icecoke0913-code/STM32F4-ventilator/参数/mq2背面.JPG

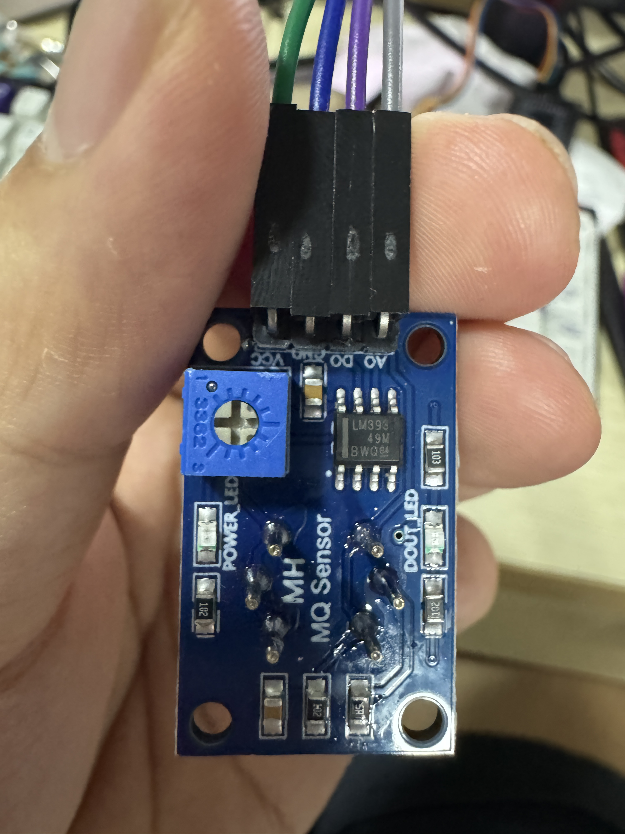
参数/mq2背面.JPG
