icecoke0913-code/STM32F4-ventilator/docs/hardware-connections.md

# 硬件连接记录

## 供电原则

- 电机电源与编码器逻辑电源分开。
- STM32、TB6612、编码器、传感器和显示屏必须共地。
- 编码器已使用3.3V供电并完成空载计数；C1/C2输出类型仍未用万用表确认，当前使用STM32内部上拉。
- MQ-2加热端使用5V，模拟输出进入STM32前不得超过3.3V。
- TB6612模块实物已带约10μF储能电容和小型去耦电容；M4使用模块现有电容。

## 计划引脚

| 模块信号 | STM32引脚 | 状态 |
|---|---|---|
| PA0用户按键 | PA0 | 板载S1，按下接3.3V，配置内部下拉 |
| 编码器A / C1 | PC6 / TIM3_CH1 | 已接线，内部上拉，固定正转时计数递减 |
| 编码器B / C2 | PC7 / TIM3_CH2 | 已接线，内部上拉，三挡空载测速正常 |
| TB6612 PWMA | PB6 / TIM4_CH1 | 已接线，20kHz PWM和30%/50%/70%空载调速通过 |
| TB6612 AIN1 | PB7 | 已接线，固定正转方向通过 |
| TB6612 AIN2 | PB8 | 已接线，固定正转方向通过 |
| TB6612 STBY | PB9 | 已接线，上电停止、0%停止和RST安全通过 |
| MQ-2 AO | PC0 / ADC1_IN10 | 必须经约0.6倍分压，禁止直接连接 |
| DHT11 DATA | PD0 | 已接线，正常采集、断线TIMEOUT和无复位自动恢复通过 |
| ST7735S SCL | PB13 / SPI2_SCK | 屏幕丝印SCL，SPI时钟 |
| ST7735S SDA | PB15 / SPI2_MOSI | 屏幕丝印SDA，SPI数据输入 |
| ST7735S CS | PD7 | 屏幕丝印CS |
| ST7735S DC | PD6 | 屏幕丝印DC |
| ST7735S RST | PD5 | 屏幕丝印RST |
| ST7735S BLK | PD4 | 屏幕丝印BLK，背光控制 |
| ST7735S VDD | 3.3V | 第一阶段使用3.3V供电 |
| ST7735S GND | GND | 与STM32共地 |
| 板载W25QXX SCK | PB3 / SPI1_SCK | 第一阶段预留，需关闭JTAG保留SWD |
| 板载W25QXX MISO | PB4 / SPI1_MISO | 第一阶段预留，需关闭JTAG保留SWD |
| 板载W25QXX MOSI | PB5 / SPI1_MOSI | 第一阶段预留 |
| 板载W25QXX CS | PA15 | 原理图网络名F_CS，第一阶段预留 |
| USART1 TX | PA9 | 已规划，未接线验证 |
| USART1 RX | PA10 | 已规划，未接线验证 |

## 电机与编码器实际六线映射

已根据购买的编码器转杜邦线转接板实物丝印确认。转接板丝印从左到右为：

```text
M2、VCC、C2、C1、GND、M1
```

| 线色 | 丝印 | 功能 | M4连接 |
|---|---|---|---|
| 绿 | M2 | 电机端2 | TB6612 AO2 |
| 橙 | VCC | 编码器3.3V电源 | 不连接，单独绝缘 |
| 黄 | C2 | 编码器相位2 | 不连接，单独绝缘 |
| 白 | C1 | 编码器相位1 | 不连接，单独绝缘 |
| 红 | GND | 编码器地 | 不连接，单独绝缘 |
| 黑 | M1 | 电机端1 | TB6612 AO1 |

M4只连接黑色M1和绿色M2。M5已将橙色VCC接3.3V、红色GND接系统地、白色C1接PC6、黄色C2接PC7。旧产品图片推断的线色映射不再使用。

## 电机转接线使用要求

电机原始六根线已通过专用转接线转换为杜邦接口，不再采用裸线临时连接。连接和移动转接线前必须先断开9V适配器、STM32 USB-C、ST-Link和USB转TTL。M5接入编码器前，需要单独确认C1/C2的电气输出类型以及是否需要外接上拉电阻，不能继续沿用旧产品图片的推断。

## M4 TB6612供电与接线

```text
9V适配器 → DC-DC输入
DC-DC 5V → TB6612 VM
STM32 3.3V → TB6612 VCC
STM32 GND、DC-DC GND、TB6612 GND → 共地
黑色M1 → TB6612 AO1
绿色M2 → TB6612 AO2
```

- 禁止把DC-DC的VIN或9V直通输出接到TB6612 VM或电机。
- STM32继续通过USB-C供电，不使用DC-DC给STM32反向供电。
- M4只使用TB6612 A通道，B通道不连接。
- M4固定使用`AIN1=高、AIN2=低`正转；方向不符合需求时，只能完全断电后交换AO1与AO2上的电机线。
- 初始安全状态为STBY低、PWM为0、AIN1低、AIN2低；上电或复位后电机不得自动旋转。

TB6612模块实物引脚按已确认照片方向从上到下为：

```text
左侧：PWMA、AIN2、AIN1、STBY、BIN1、BIN2、PWMB、GND
右侧：VM、VCC、GND、AO1、AO2、BO2、BO1、GND
```

## MQ-2分压要求

- 模块VCC接5V，GND接系统地。
- 商家《产品使用手册》明确写明：该LM393模块的模拟量输出为`0~5V`，浓度越高电压越高；因此AO不是3.3V安全输出。
- 只使用AO，第一阶段不使用DO。
- AO先经过约0.6倍分压再进入PC0，例如AO经10kΩ串联到PC0、PC0再经15kΩ接地。
- 分压后的理论最大值为5V × 15/(10+15) = 3.0V。
- 正式接PC0前，先用万用表测量模块AO和分压节点电压。
- 手册同时称DO为低电平有效TTL输出且“可直接接单片机”，但未给出高电平最大电压；PC0是ADC输入，不可把DO接到PC0。若以后使用DO，必须选择确认具备5V容忍能力的数字GPIO，并先核对开发板实际引脚。
- 当前没有万用表和分压器件，MQ-2的AO、DO均保持断开。

## DHT11接线要求

M3A使用三针DHT11模块，规划接线为：

| DHT11信号 | 连接位置 | 说明 |
|---|---|---|
| VCC | STM32 3.3V | 不使用5V，确保板载数据上拉电平安全 |
| DATA | PD0 | 单总线数据，驱动中动态切换开漏输出与输入 |
| GND | STM32 GND | 与开发板共地 |

- 三针模块通常带板载数据上拉，因此M3A不增加外部上拉电阻。
- 接线前必须按实物丝印确认VCC、DATA和GND顺序，不能按针脚位置猜测。
- M3A测试时MQ-2的AO和DO均不得连接STM32。
- DHT11运行中DATA线断开会稳定报告TIMEOUT，重新接回后无需复位即可恢复OK；两次重复测试均已通过。

## 已确认电机参数

- 型号：JGA12-N20-50B。
- 额定电压：6V；允许范围：3～12V。
- 空载转速：300 RPM；空载电流：40mA。
- 最大效率点：225 RPM、155mA、0.14kg·cm。
- 堵转电流：0.55A；堵转转矩：0.7kg·cm。
- 减速比：50。
- 编码器四倍频理论计数：1400计数/输出轴圈。

## 待确认项

- ST7735S实际显示方向、颜色顺序和坐标偏移。
- ST7735S最终校准：竖屏128×160，MADCTL=0xC0，X Offset=0，Y Offset=0，BLK高电平点亮，SPI2时钟5.25MHz。
- 首次白屏由显示通信线物理连接不良导致；断电重新插接后恢复。移动杜邦线前必须先断开USB-C、ST-Link和USB转TTL。
- MQ-2模块AO及分压节点的实测最大电压。
- DC-DC模块实际输入电压，以及5V/3.3V各路实测电压。
- TB6612开环挡位与空载运行已通过；未使用万用表测量5V或启动压降，未进行堵转、带负载或长时间运行测试。

## 开发板原理图核对记录

- 资料：根目录 `stm32f407vet6.pdf`。
- MCU外部高速晶振：8 MHz。
- MCU外部低速晶振：32.768 kHz。
- 板载用户按键S1连接PA0，按下通过1 kΩ接到3.3V。
- 板载用户LED连接PA1，实际亮灭电平在M1阶段验证。
- P2 TFT接口：1=3.3V、2=GND、3=PB15、4=PB13、5=PB12、6=PB14、7=PC5、8=PB1；因购买的屏幕接口不匹配，本项目不使用该插座。
- 板载W25QXX：PA15=CS、PB3=SCK、PB4=MISO、PB5=MOSI。

## 参数资料来源

- `参数/st7735s背面.JPG`、`参数/st7735正面.JPG`
- `参数/mq2背面.JPG`、`参数/mq2正面.JPG`
- `参数/MQ-2.pdf`
- `参数/产品使用手册.doc`
- `参数/电机参数.png`
- `参数/电源模块.png`
- `参数/TB6612FNG_datasheet.pdf`
