icecoke0913-code/STM32F4-ventilator/docs/superpowers/plans/2026-08-18-m8a-dht11-auto.md

# M8A DHT11自动模式实施计划

> **For agentic workers:** REQUIRED SUB-SKILL: Use superpowers:executing-plans (recommended) or superpowers:subagent-driven-development to implement this plan task-by-task. Steps use checkbox (`- [ ]`) syntax for tracking.

**Goal:** 在不接入MQ-2的前提下，让DHT11温湿度驱动AUTO的STOP/LOW/HIGH目标，并验证传感器失效时安全停止。

**Architecture:** 新增纯函数`AutoPolicy`计算AUTO候选请求；App层以CMSIS-RTOS互斥量保护最新有效DHT11快照；MotorTask每50ms读取快照并通过扩展后的ModeManager生成最终请求。MANUAL、BACKFLOW、编码器故障和MotorTask唯一PWM所有权保持不变。

**Tech Stack:** STM32F407VET6、STM32CubeMX 6.16.1、STM32CubeF4 1.28.3、HAL、FreeRTOS/CMSIS-RTOS v2、Keil MDK-ARM V5、C。

**设计依据：** `docs/superpowers/specs/2026-08-18-m8a-dht11-auto-design.md`

---

### Task 1: 建立M8A基线和文档检查点

**Files:**
- Modify: `docs/superpowers/plans/2026-08-18-m8a-dht11-auto.md`
- Read: `firmware/SmartHood/App/Src/app_tasks.c`
- Read: `firmware/SmartHood/Control/Inc/mode_manager.h`

- [x] **Step 1: 确认工作区和正式开关**

```powershell
git status --short --branch
git log -3 --oneline --decorate
rg -n "APP_M7_SELF_TEST_ENABLED|APP_CONTROL_PI_SELF_TEST_ENABLED" `
  firmware/SmartHood/App/Src/app_tasks.c
```

Expected: 当前为`main...origin/main`，工作区干净，M7和PI临时自检开关均为`0U`。

- [x] **Step 2: 完整Rebuild基线**

```powershell
$uv4 = 'D:\Keil5\UV4\UV4.exe'
$project = 'D:\Keil5 prj\stm32f4\firmware\SmartHood\MDK-ARM\SmartHood.uvprojx'
$log = Join-Path $env:TEMP 'smarthood-m8a-baseline.log'
$args = @('-r', ('"' + $project + '"'), '-t', '"SmartHood"', '-o', ('"' + $log + '"'))
$p = Start-Process -FilePath $uv4 -ArgumentList $args -WindowStyle Hidden -Wait -PassThru
Get-Content $log
Write-Output ('UV4_EXIT=' + $p.ExitCode)
```

Expected: `0 Error(s), 0 Warning(s)`，正式尺寸仍为`Code=28778 RO-data=1422 RW-data=168 ZI-data=39672`。

- [x] **Step 3: 提交M8A基线记录**

```powershell
git add docs/superpowers/plans/2026-08-18-m8a-dht11-auto.md
git commit -m "docs: start M8A DHT11 auto implementation"
git push origin main
```

### Task 2: 为AutoPolicy写失败自检

**Files:**
- Create: `firmware/SmartHood/Control/Inc/auto_policy.h`
- Create: `firmware/SmartHood/Control/Test/auto_policy_selftest.h`
- Create: `firmware/SmartHood/Control/Test/auto_policy_selftest.c`
- Modify: `firmware/SmartHood/MDK-ARM/SmartHood.uvprojx`

- [x] **Step 1: 定义数据结构和纯函数接口**

在`auto_policy.h`中定义`AutoPolicySnapshot_t`，包含`int16_t temperature_x10`、`uint16_t humidity_x10`、`bool valid`和`uint32_t updated_tick`，并声明：

```c
ModeMotorRequest_t AutoPolicy_Evaluate(
    const AutoPolicySnapshot_t *snapshot,
    uint32_t now_tick,
    ModeMotorRequest_t previous_auto_request);
```

头文件必须包含`stdbool.h`、`stdint.h`和`mode_manager.h`，所有新增公开接口加中文注释。

- [x] **Step 2: 先写自检断言**

`auto_policy_selftest.c`分别构造独立快照和上一次请求，覆盖以下结果：

```c
valid=false                         -> MODE_MOTOR_STOP
updated_tick距now超过6000ms         -> MODE_MOTOR_STOP
26.0C/60%且previous=STOP            -> STOP
28.0C/60%且previous=STOP            -> LOW
32.0C/60%且previous=LOW             -> HIGH
31.0C/80%且previous=HIGH             -> LOW
27.0C/65%且previous=LOW              -> STOP
31.5C/82%且previous=HIGH             -> HIGH
非法previous请求                    -> 按STOP基线重新计算
```

每个断言失败立即返回`false`，中间结果不得使用`(void)`丢弃。

`auto_policy_selftest.h`声明`bool AutoPolicy_RunSelfTests(void);`，并包含必要的`stdbool.h`。

- [x] **Step 3: 将自检加入Keil工程并执行红灯Rebuild**

把`auto_policy_selftest.c`加入Keil的`Control Test` Group，确认已有`..Control\Inc;..\Control\Test`包含路径；执行完整Rebuild。

Expected: 链接阶段报告`AutoPolicy_Evaluate`未定义，得到大于0个Error，证明自检确实调用了尚未实现的接口。

### Task 3: 实现AutoPolicy最小逻辑

**Files:**
- Create: `firmware/SmartHood/Control/Src/auto_policy.c`
- Modify: `firmware/SmartHood/MDK-ARM/SmartHood.uvprojx`
- Test: `firmware/SmartHood/Control/Test/auto_policy_selftest.c`

- [x] **Step 1: 加入AutoPolicy实现**

在`auto_policy.c`中使用无符号Tick差判断过期：

```c
if ((snapshot == NULL) || !snapshot->valid ||
    ((uint32_t)(now_tick - snapshot->updated_tick) > 6000U))
{
    return MODE_MOTOR_STOP;
}
```

实现顺序必须是：先判断HIGH进入阈值，再依据`previous_auto_request`执行HIGH降档或LOW停止迟滞，最后判断LOW进入阈值。所有温湿度比较使用扩大10倍的整数：`320`、`850`、`310`、`800`、`280`、`700`、`270`、`650`。

- [x] **Step 2: 加入Keil工程并执行绿灯Rebuild**

将`auto_policy.c`加入`Control` Group，重新Rebuild。

Expected: `0 Error(s), 0 Warning(s)`；自检对象和实现对象均参与编译。

- [x] **Step 3: 提交纯算法模块**

```powershell
git add firmware/SmartHood/Control/Inc/auto_policy.h `
  firmware/SmartHood/Control/Src/auto_policy.c `
  firmware/SmartHood/Control/Test/auto_policy_selftest.c `
  firmware/SmartHood/Control/Test/auto_policy_selftest.h `
  firmware/SmartHood/MDK-ARM/SmartHood.uvprojx
git diff --cached --check
git commit -m "feat: add DHT11 auto policy"
git push origin main
```

### Task 4: 增加线程安全的DHT11快照

**Files:**
- Modify: `firmware/SmartHood/App/Src/app_tasks.c`
- Modify: `firmware/SmartHood/Core/Src/freertos.c`

- [x] **Step 1: 在App层增加共享对象**

在`app_tasks.c`中增加：

```c
static osMutexId_t app_sensor_mutex = NULL;
static AutoPolicySnapshot_t app_sensor_snapshot = {0};
```

增加三个带中文注释的静态函数：

```c
static bool App_SensorState_Init(void);
static void App_SensorState_Publish(const DHT11_Data_t *data,
                                    uint32_t now_tick);
static bool App_SensorState_Read(AutoPolicySnapshot_t *snapshot);
```

`App_SensorState_Init()`创建互斥量并将快照置为`valid=false`；Publish和Read在复制结构时使用`osMutexAcquire(..., 0U)`，失败时返回安全失败结果，不在锁内执行DHT11读取。

- [x] **Step 2: 在任务创建前初始化互斥量**

在`MX_FREERTOS_Init()`的`App_MotorControl_Init()`之后调用`App_SensorState_Init()`；失败调用`Error_Handler()`，保证三个任务启动前共享对象已经存在。

- [x] **Step 3: 发布有效DHT11数据**

在`App_SensorTask()`中，只有`BSP_DHT11_Read()`返回`DHT11_STATUS_OK`时调用`App_SensorState_Publish(&data, osKernelGetTickCount())`；TIMEOUT和CHECKSUM_ERROR只保留原有日志，不发布无效数据。

- [x] **Step 4: 执行Rebuild并提交**

Expected: `0 Error(s), 0 Warning(s)`，SensorTask原有日志行为保持不变。

```powershell
git add firmware/SmartHood/App/Src/app_tasks.c `
  firmware/SmartHood/App/Inc/app_tasks.h firmware/SmartHood/Core/Src/freertos.c
git diff --cached --check
git commit -m "feat: share validated DHT11 snapshot"
git push origin main
```

### Task 5: 扩展ModeManager并保持M7回归

**Files:**
- Modify: `firmware/SmartHood/Control/Inc/mode_manager.h`
- Modify: `firmware/SmartHood/Control/Src/mode_manager.c`
- Modify: `firmware/SmartHood/Control/Test/mode_manager_selftest.c`

- [x] **Step 1: 修改请求映射接口**

把接口改为：

```c
ModeMotorRequest_t ModeManager_GetMotorRequest(
    const ModeManager_t *manager,
    ModeMotorRequest_t auto_request);
```

AUTO且RUNNING且无故障时返回`auto_request`，但只接受STOP/LOW/HIGH；非法AUTO请求返回STOP。MANUAL忽略`auto_request`并继续使用预选挡位；BACKFLOW返回STOP；故障返回FAULT；STANDBY返回STOP。

- [x] **Step 2: 先更新所有自检调用**

M7已有自检调用统一传入`MODE_MOTOR_STOP`，并新增AUTO运行状态下传入LOW/HIGH/FAULT/非法值的断言。确认MANUAL和BACKFLOW结果不随第二参数改变。

- [x] **Step 3: 执行Rebuild并复核M7自检**

Expected: `0 Error(s), 0 Warning(s)`；临时打开M7自检时仍输出`M7 self-test PASSED`，否则保持正式开关为`0U`并继续下一步。

- [x] **Step 4: 提交ModeManager接口扩展**

```powershell
git add firmware/SmartHood/Control/Inc/mode_manager.h `
  firmware/SmartHood/Control/Src/mode_manager.c `
  firmware/SmartHood/Control/Test/mode_manager_selftest.c
git diff --cached --check
git commit -m "feat: allow mode manager auto requests"
git push origin main
```

### Task 6: 将AUTO策略接入MotorTask

**Files:**
- Modify: `firmware/SmartHood/App/Src/app_tasks.c`
- Modify: `firmware/SmartHood/Control/Test/auto_policy_selftest.c`

- [x] **Step 1: 增加AUTO候选请求状态**

在`App_MotorTask()`局部变量中增加`AutoPolicySnapshot_t sensor_snapshot`、`ModeMotorRequest_t auto_request`和`ModeMotorRequest_t previous_auto_request = MODE_MOTOR_STOP`。每个50ms周期先把`sensor_snapshot.valid`置为`false`，再调用`App_SensorState_Read()`；读取失败时保留这个无效快照并传给策略函数。

- [x] **Step 2: 计算最终请求**

将原来的：

```c
request = ModeManager_GetMotorRequest(&mode_manager);
```

改为：

```c
auto_request = AutoPolicy_Evaluate(
    &sensor_snapshot, now_tick, previous_auto_request);
request = ModeManager_GetMotorRequest(&mode_manager, auto_request);
previous_auto_request = auto_request;
```

最终请求变化后继续复用已有`App_MotorRequestToAction()`、PI复位和软启动逻辑；AUTO进入STOP时沿用`stop_motor`立即停机。

- [x] **Step 3: 增加可观察日志**

在现有约500ms控制日志中追加`auto_request`、`temp`、`humidity`和`sensor_age`字段；传感器无效时输出固定`temp=NA humidity=NA sensor_age=STALE`，不使用浮点格式化。

- [x] **Step 4: 执行Rebuild并提交集成**

Expected: `0 Error(s), 0 Warning(s)`；关闭临时自检时正式尺寸允许增加，但不能出现未定义符号或警告。

```powershell
git add firmware/SmartHood/App/Src/app_tasks.c
git diff --cached --check
git commit -m "feat: integrate DHT11 auto requests"
git push origin main
```

### Task 7: 加入M8A组合自检和临时板端验证

**Files:**
- Modify: `firmware/SmartHood/App/Src/app_tasks.c`
- Modify: `docs/test-records.md`

- [x] **Step 1: 增加组合自检函数**

在`APP_M8A_SELF_TEST_ENABLED`条件编译下增加`App_M8A_RunSelfTests()`，组合调用AutoPolicy和ModeManager自检，并验证：AUTO+RUNNING+LOW请求可达、AUTO+RUNNING+STOP停止、MANUAL不被AUTO候选请求覆盖、故障优先级不变。

- [x] **Step 2: 临时打开自检并Rebuild**

```c
#define APP_M8A_SELF_TEST_ENABLED 1U
```

Expected: `0 Error(s), 0 Warning(s)`，尺寸变化可记录，但不能出现警告。

- [x] **Step 3: VM断开条件下烧录**

完全断电，断开TB6612 `VM/9V`，保持ST-Link、USB转TTL、TFT和DHT11连接；烧录后打开115200串口并按RST。

Expected: `M8A auto policy self-test PASSED`、DHT11有效日志和`motor control ready, state=STOP`；电机不得转动。

- [x] **Step 4: 记录板端自检结果**

把实际串口现象写入`docs/test-records.md`，明确VM断开、DHT11接线和没有安装扇叶/机械负载。

### Task 8: VM断开系统行为验收

**Files:**
- Modify: `docs/test-records.md`

- [ ] **Step 1: 验证无效和恢复**

未执行运行中DHT11断线：项目禁止带电插拔传感器线路；无效快照和6000ms过期STOP由板端固定输入自检覆盖。

在VM断开时保持系统运行，确认DHT11为`status=OK`；断开DHT11 DATA线，观察最多约6秒后AUTO候选变为STOP；重新接回并等待有效读取，确认候选请求恢复。

- [x] **Step 2: 验证AUTO模式切换**

长按取得RUNNING，保持AUTO，观察温湿度和AUTO请求日志；短按进入MANUAL，确认双击LOW/HIGH仍按M7规则工作；再次短按进入BACKFLOW，确认请求仍为STOP。

- [ ] **Step 3: 验证安全停止**

STANDBY和RST停止已通过；本阶段未重复执行编码器运行中断线，因此该步骤保留未勾选。

验证长按进入STANDBY、RST复位、编码器故障锁存和故障长按清除；所有路径都必须保持PWM为0，无VM时不得因策略日志导致任务阻塞。

- [x] **Step 4: 关闭临时自检**

恢复：

```c
#define APP_M8A_SELF_TEST_ENABLED 0U
```

### Task 9: 正式构建、文档和Git收尾

**Files:**
- Modify: `firmware/SmartHood/App/Src/app_tasks.c`
- Modify: `docs/project-guide.md`
- Modify: `docs/test-records.md`
- Modify: `docs/superpowers/plans/2026-08-18-m8a-dht11-auto.md`

- [x] **Step 1: 正式Rebuild**

Expected: Keil `0 Error(s), 0 Warning(s)`，记录Code/RO/RW/ZI和HEX SHA-256；正式开关必须为`0U`。

- [x] **Step 2: 更新项目文档**

只把实际完成的DHT11 AUTO、数据过期停止、MANUAL/BACKFLOW回归和VM断开验收标为通过；MQ-2融合、真实BACKFLOW、扇叶、机械负载、堵转和长时间温升继续标记为未执行或未开始。

- [x] **Step 3: 提交正式版本**

```powershell
git add firmware/SmartHood/App/Src/app_tasks.c `
  docs/project-guide.md docs/test-records.md `
  docs/superpowers/plans/2026-08-18-m8a-dht11-auto.md
git diff --cached --check
git commit -m "feat: add DHT11 automatic mode"
git push origin main
git status --short --branch
```

Expected: `main...origin/main`且工作区无未提交文件。

---

## 执行前安全约束

- MQ-2 AO/DO在整个M8A计划中保持断开；没有分压器件和万用表时不改变此约束。
- 所有临时自检烧录和DHT11断线测试都必须断开TB6612 VM/9V。
- 禁止安装扇叶、机械负载或执行堵转测试。
- 禁止带电插拔电机、TB6612、编码器或传感器线路。
- 正式M8A固件烧录前确认`APP_M8A_SELF_TEST_ENABLED=0U`。
