icecoke0913-code/STM32F4-ventilator/docs/superpowers/plans/2026-07-23-m2-st7735s-display.md

# M2 ST7735S Display Implementation Plan

> **For agentic workers:** REQUIRED SUB-SKILL: Use superpowers:subagent-driven-development (recommended) or superpowers:executing-plans to implement this plan task-by-task. Steps use checkbox (`- [ ]`) syntax for tracking.

**Goal:** Configure SPI2 and build a project-specific blocking HAL driver that initializes and validates the external 1.8-inch 128×160 ST7735S display while preserving the M1 FreeRTOS heartbeat, key and serial functions.

**Architecture:** CubeMX owns SPI2 and GPIO initialization. Handwritten display transport, graphics primitives and a minimal hardware-test font live in the BSP layer; `App_DefaultTask` calls only public BSP functions. The first version uses blocking SPI without a framebuffer, DMA or a new RTOS task, while preserving an RGB565 rectangle-write boundary for the M9 LVGL port.

**Tech Stack:** STM32F407VET6, STM32CubeMX 6.16.1, STM32CubeF4 1.28.3, Keil MDK 5.24a/ARMCC 5.06, STM32 HAL, FreeRTOS CMSIS-RTOS v2, SPI2, ST7735S

---

## M2 Safety and Acceptance

During M2, connect only the STM32 board, ST-Link, USB-to-UART and TFT. Do not connect MQ-2, DHT11, TB6612, motor or encoder.

Power arrangement:

```text
STM32 board: USB-C
TFT: board 3.3V and board GND
ST-Link: SWDIO, SWCLK and GND only
ST-Link 3.3V/5V: disconnected
USB-to-UART power pins: disconnected
```

M2 functionally passes when:

- Keil reports `0 Error(s), 0 Warning(s)`.
- M1 USART1 heartbeat, PA0 and PA1 behavior remain operational.
- PD4 controls the TFT backlight.
- Red, green and blue test screens match their requested colors.
- Portrait coordinates cover `(0,0)` through `(127,159)` without a missing edge.
- The final test screen shows `SmartHood`, `ST7735S OK` and `128x160`.
- No unexpected reset occurs during repeated display operations.

## Planned Files

```text
Modify: firmware/SmartHood/SmartHood.ioc
Generate: firmware/SmartHood/Core/Inc/spi.h
Generate: firmware/SmartHood/Core/Src/spi.c
Generate/modify: firmware/SmartHood/Core/Inc/main.h
Generate/modify: firmware/SmartHood/Core/Src/gpio.c
Create: firmware/SmartHood/BSP/Inc/fonts.h
Create: firmware/SmartHood/BSP/Src/fonts.c
Create: firmware/SmartHood/BSP/Inc/bsp_st7735s.h
Create: firmware/SmartHood/BSP/Src/bsp_st7735s.c
Modify: firmware/SmartHood/App/Src/app_tasks.c
Modify through Keil GUI: firmware/SmartHood/MDK-ARM/SmartHood.uvprojx
Update: docs/hardware-connections.md
Update: docs/test-records.md
Update: docs/project-guide.md
```

### Task 1: Protect the M1 Baseline

**Files:**

- Verify: `firmware/SmartHood/SmartHood.ioc`
- Verify: `firmware/SmartHood/Core/Src/freertos.c`
- Verify: `firmware/SmartHood/App/Src/app_tasks.c`

- [x] **Step 1: Commit the approved M2 documents on main and create a feature branch**

```powershell
git add docs/project-guide.md docs/superpowers/plans/2026-07-23-m2-st7735s-display.md
git commit -m "docs: add M2 ST7735S implementation plan"
git push
git switch -c feature/m2-st7735s
```

Expected: the new local branch is `feature/m2-st7735s` and M2 firmware changes do not start directly on `main`.

- [x] **Step 2: Confirm the Git working tree before CubeMX changes**

Run from the repository root:

```powershell
git status
git log --oneline -3
```

Expected: the current M1 work is committed, and no unexplained source change is pending.

- [x] **Step 3: Record the current build**

Press `F7` in Keil.

Expected:

```text
0 Error(s), 0 Warning(s)
Program Size: Code=18416 RO-data=1048 RW-data=148 ZI-data=39364
```

The exact size may differ slightly after Keil project metadata changes, but any difference must be explained.

- [x] **Step 4: Confirm CubeMX preservation points**

In `Core/Src/freertos.c`, confirm:

```c
/* USER CODE BEGIN Includes */
#include "app_tasks.h"
/* USER CODE END Includes */
```

and:

```c
void StartDefaultTask(void *argument)
{
  /* USER CODE BEGIN StartDefaultTask */
  App_DefaultTask(argument);
  /* USER CODE END StartDefaultTask */
}
```

Stop if either block is missing.

### Task 2: Configure SPI2 and TFT GPIO in CubeMX

**Files:**

- Modify: `firmware/SmartHood/SmartHood.ioc`
- Generate: `firmware/SmartHood/Core/Inc/spi.h`
- Generate: `firmware/SmartHood/Core/Src/spi.c`
- Generate/modify: `firmware/SmartHood/Core/Inc/main.h`
- Generate/modify: `firmware/SmartHood/Core/Src/gpio.c`

- [x] **Step 1: Enable SPI2 transmit-only master mode**

Open `SmartHood.ioc`, then choose `Connectivity -> SPI2`:

```text
Mode: Transmit Only Master
PB13: SPI2_SCK
PB15: SPI2_MOSI
```

PB14 is not used by the display.

- [x] **Step 2: Configure the SPI2 parameter settings**

Use:

```text
Frame Format: Motorola
Data Size: 8 Bits
First Bit: MSB First
Clock Polarity: Low
Clock Phase: 1 Edge
Baud Rate Prescaler: 8
NSS Signal Type: Software
CRC Calculation: Disabled
```

With APB1 at 42MHz, the initial SPI2 clock is `42MHz / 8 = 5.25MHz`.

Do not enable SPI2 DMA or interrupts.

- [x] **Step 3: Configure TFT_CS on PD7**

Select PD7 as `GPIO_Output`:

```text
User Label: TFT_CS
Initial Output Level: High
Mode: Output Push Pull
Pull: No Pull
Speed: Low
```

- [x] **Step 4: Configure TFT_DC on PD6**

Select PD6 as `GPIO_Output`:

```text
User Label: TFT_DC
Initial Output Level: Low
Mode: Output Push Pull
Pull: No Pull
Speed: Low
```

- [x] **Step 5: Configure TFT_RST on PD5**

Select PD5 as `GPIO_Output`:

```text
User Label: TFT_RST
Initial Output Level: High
Mode: Output Push Pull
Pull: No Pull
Speed: Low
```

- [x] **Step 6: Configure TFT_BLK on PD4**

Select PD4 as `GPIO_Output`:

```text
User Label: TFT_BLK
Initial Output Level: Low
Mode: Output Push Pull
Pull: No Pull
Speed: Low
```

- [x] **Step 7: Check the clock and pin map before generation**

Confirm that the existing clock tree remains:

```text
SYSCLK/HCLK: 168MHz
APB1: 42MHz
APB2: 84MHz
```

Confirm no red conflict marker appears on PB13, PB15 or PD4-PD7.

- [x] **Step 8: Generate the code**

Click `GENERATE CODE`.

After generation, confirm these macros exist in `Core/Inc/main.h`:

```c
#define TFT_BLK_Pin GPIO_PIN_4
#define TFT_BLK_GPIO_Port GPIOD
#define TFT_RST_Pin GPIO_PIN_5
#define TFT_RST_GPIO_Port GPIOD
#define TFT_DC_Pin GPIO_PIN_6
#define TFT_DC_GPIO_Port GPIOD
#define TFT_CS_Pin GPIO_PIN_7
#define TFT_CS_GPIO_Port GPIOD
```

- [x] **Step 9: Reopen Keil and repair the old DFP mapping only if CubeMX overwrote it**

The old compatible pack uses:

```text
Device: STM32F407VE
Pack: Keil.STM32F4xx_DFP.1.0.8
```

Do not change the MCU source define or startup file manually. Remap the Keil target device through `Options for Target -> Device` only if the project reports the old device-pack error again.

- [x] **Step 10: Perform an empty-peripheral build**

Press `F7` before adding BSP code.

Expected:

```text
compiling spi.c...
0 Error(s), 0 Warning(s)
```

Verify that USART1 heartbeat still works after flashing this generated-only build.

- [x] **Step 11: Commit the CubeMX peripheral configuration**

```powershell
git add firmware/SmartHood/SmartHood.ioc firmware/SmartHood/Core firmware/SmartHood/MDK-ARM/SmartHood.uvprojx
git commit -m "feat: configure SPI2 and TFT control GPIO"
git push
```

### Task 3: Create the BSP Structure and Minimal Test Font

**Files:**

- Create: `firmware/SmartHood/BSP/Inc/fonts.h`
- Create: `firmware/SmartHood/BSP/Src/fonts.c`
- Modify through Keil GUI: `firmware/SmartHood/MDK-ARM/SmartHood.uvprojx`

- [x] **Step 1: Create BSP directories**

Create:

```text
firmware/SmartHood/BSP/Inc
firmware/SmartHood/BSP/Src
```

- [x] **Step 2: Create `fonts.h`**

```c
#ifndef FONTS_H
#define FONTS_H

#include <stdbool.h>
#include <stdint.h>

#define FONT_5X7_WIDTH   5U
#define FONT_5X7_HEIGHT  7U

bool Fonts_GetGlyph5x7(char character, uint8_t glyph[FONT_5X7_WIDTH]);

#endif
```

- [x] **Step 3: Create `fonts.c`**

The M2 font intentionally contains only characters required by the hardware-test screen. M9 uses LVGL fonts instead of extending this table.

```c
#include "fonts.h"

#include <stddef.h>

typedef struct
{
    char character;
    uint8_t columns[FONT_5X7_WIDTH];
} FontGlyph5x7;

static const FontGlyph5x7 glyphs[] =
{
    { ' ', { 0x00U, 0x00U, 0x00U, 0x00U, 0x00U } },
    { '?', { 0x02U, 0x01U, 0x51U, 0x09U, 0x06U } },
    { '0', { 0x3EU, 0x51U, 0x49U, 0x45U, 0x3EU } },
    { '1', { 0x00U, 0x42U, 0x7FU, 0x40U, 0x00U } },
    { '2', { 0x42U, 0x61U, 0x51U, 0x49U, 0x46U } },
    { '3', { 0x21U, 0x41U, 0x45U, 0x4BU, 0x31U } },
    { '5', { 0x27U, 0x45U, 0x45U, 0x45U, 0x39U } },
    { '6', { 0x3CU, 0x4AU, 0x49U, 0x49U, 0x30U } },
    { '7', { 0x01U, 0x71U, 0x09U, 0x05U, 0x03U } },
    { '8', { 0x36U, 0x49U, 0x49U, 0x49U, 0x36U } },
    { 'H', { 0x7FU, 0x08U, 0x08U, 0x08U, 0x7FU } },
    { 'K', { 0x7FU, 0x08U, 0x14U, 0x22U, 0x41U } },
    { 'O', { 0x3EU, 0x41U, 0x41U, 0x41U, 0x3EU } },
    { 'S', { 0x46U, 0x49U, 0x49U, 0x49U, 0x31U } },
    { 'T', { 0x01U, 0x01U, 0x7FU, 0x01U, 0x01U } },
    { 'a', { 0x20U, 0x54U, 0x54U, 0x54U, 0x78U } },
    { 'd', { 0x38U, 0x44U, 0x44U, 0x48U, 0x7FU } },
    { 'm', { 0x7CU, 0x04U, 0x18U, 0x04U, 0x78U } },
    { 'o', { 0x38U, 0x44U, 0x44U, 0x44U, 0x38U } },
    { 'r', { 0x7CU, 0x08U, 0x04U, 0x04U, 0x08U } },
    { 't', { 0x04U, 0x3FU, 0x44U, 0x40U, 0x20U } },
    { 'x', { 0x44U, 0x28U, 0x10U, 0x28U, 0x44U } }
};

bool Fonts_GetGlyph5x7(char character, uint8_t glyph[FONT_5X7_WIDTH])
{
    size_t index;
    size_t column;
    const uint8_t *source = NULL;

    if (glyph == NULL)
    {
        return false;
    }

    for (index = 0U; index < (sizeof(glyphs) / sizeof(glyphs[0])); index++)
    {
        if (glyphs[index].character == character)
        {
            source = glyphs[index].columns;
            break;
        }
    }

    if (source == NULL)
    {
        for (index = 0U; index < (sizeof(glyphs) / sizeof(glyphs[0])); index++)
        {
            if (glyphs[index].character == '?')
            {
                source = glyphs[index].columns;
                break;
            }
        }
    }

    if (source == NULL)
    {
        return false;
    }

    for (column = 0U; column < FONT_5X7_WIDTH; column++)
    {
        glyph[column] = source[column];
    }

    return true;
}
```

- [x] **Step 4: Add the BSP group and include path in Keil**

Create a Keil group named `BSP`, add `BSP/Src/fonts.c`, and add this include path:

```text
..\BSP\Inc
```

Keep the existing `..\App\Inc` path.

- [x] **Step 5: Build the font module**

Press `F7`.

Expected:

```text
compiling fonts.c...
0 Error(s), 0 Warning(s)
```

### Task 4: Add the ST7735S Public Interface

**Files:**

- Create: `firmware/SmartHood/BSP/Inc/bsp_st7735s.h`

- [x] **Step 1: Create `bsp_st7735s.h`**

```c
#ifndef BSP_ST7735S_H
#define BSP_ST7735S_H

#include <stdbool.h>
#include <stdint.h>

#define ST7735S_WIDTH   128U
#define ST7735S_HEIGHT  160U

#define ST7735S_COLOR_BLACK  0x0000U
#define ST7735S_COLOR_WHITE  0xFFFFU
#define ST7735S_COLOR_RED    0xF800U
#define ST7735S_COLOR_GREEN  0x07E0U
#define ST7735S_COLOR_BLUE   0x001FU
#define ST7735S_COLOR_YELLOW 0xFFE0U
#define ST7735S_COLOR_CYAN   0x07FFU
#define ST7735S_COLOR_MAGENTA 0xF81FU

bool BSP_ST7735S_Init(void);
void BSP_ST7735S_SetBacklight(bool enabled);
bool BSP_ST7735S_SetAddressWindow(uint16_t x,
                                 uint16_t y,
                                 uint16_t width,
                                 uint16_t height);
bool BSP_ST7735S_WritePixels(const uint16_t *pixels, uint32_t count);
bool BSP_ST7735S_FillScreen(uint16_t color);
bool BSP_ST7735S_DrawPixel(uint16_t x, uint16_t y, uint16_t color);
bool BSP_ST7735S_FillRect(uint16_t x,
                         uint16_t y,
                         uint16_t width,
                         uint16_t height,
                         uint16_t color);
bool BSP_ST7735S_DrawChar(uint16_t x,
                         uint16_t y,
                         char character,
                         uint16_t foreground,
                         uint16_t background);
bool BSP_ST7735S_DrawString(uint16_t x,
                           uint16_t y,
                           const char *text,
                           uint16_t foreground,
                           uint16_t background);

#endif
```

- [x] **Step 2: Explain the LVGL-compatible boundary before implementation**

`BSP_ST7735S_SetAddressWindow()` plus `BSP_ST7735S_WritePixels()` form the future M9 LVGL flush boundary. M2 does not include or configure LVGL.

### Task 5: Implement the ST7735S Transport and Initialization

**Files:**

- Create: `firmware/SmartHood/BSP/Src/bsp_st7735s.c`
- Modify through Keil GUI: `firmware/SmartHood/MDK-ARM/SmartHood.uvprojx`

- [x] **Step 1: Create the constants and low-level SPI helpers**

Start `bsp_st7735s.c` with:

```c
#include "bsp_st7735s.h"

#include <stddef.h>

#include "fonts.h"
#include "main.h"
#include "spi.h"

#define ST7735S_CMD_SWRESET  0x01U
#define ST7735S_CMD_SLPOUT   0x11U
#define ST7735S_CMD_NORON    0x13U
#define ST7735S_CMD_INVOFF   0x20U
#define ST7735S_CMD_DISPON   0x29U
#define ST7735S_CMD_CASET    0x2AU
#define ST7735S_CMD_RASET    0x2BU
#define ST7735S_CMD_RAMWR    0x2CU
#define ST7735S_CMD_MADCTL   0x36U
#define ST7735S_CMD_COLMOD   0x3AU
#define ST7735S_CMD_FRMCTR1  0xB1U
#define ST7735S_CMD_FRMCTR2  0xB2U
#define ST7735S_CMD_FRMCTR3  0xB3U
#define ST7735S_CMD_INVCTR   0xB4U
#define ST7735S_CMD_PWCTR1   0xC0U
#define ST7735S_CMD_PWCTR2   0xC1U
#define ST7735S_CMD_PWCTR3   0xC2U
#define ST7735S_CMD_PWCTR4   0xC3U
#define ST7735S_CMD_PWCTR5   0xC4U
#define ST7735S_CMD_VMCTR1   0xC5U
#define ST7735S_CMD_GMCTRP1  0xE0U
#define ST7735S_CMD_GMCTRN1  0xE1U

#define ST7735S_SPI_TIMEOUT_MS  100U
#define ST7735S_PIXEL_CHUNK      32U
#define ST7735S_X_OFFSET          0U
#define ST7735S_Y_OFFSET          0U
#define ST7735S_MADCTL_PORTRAIT  0xC0U

static void ST7735S_Select(void)
{
    HAL_GPIO_WritePin(TFT_CS_GPIO_Port, TFT_CS_Pin, GPIO_PIN_RESET);
}

static void ST7735S_Unselect(void)
{
    HAL_GPIO_WritePin(TFT_CS_GPIO_Port, TFT_CS_Pin, GPIO_PIN_SET);
}

static bool ST7735S_Transmit(const uint8_t *data, uint16_t length)
{
    if ((data == NULL) || (length == 0U))
    {
        return false;
    }

    return HAL_SPI_Transmit(&hspi2,
                            (uint8_t *)data,
                            length,
                            ST7735S_SPI_TIMEOUT_MS) == HAL_OK;
}

static bool ST7735S_WriteCommand(uint8_t command)
{
    bool result;

    HAL_GPIO_WritePin(TFT_DC_GPIO_Port, TFT_DC_Pin, GPIO_PIN_RESET);
    ST7735S_Select();
    result = ST7735S_Transmit(&command, 1U);
    ST7735S_Unselect();

    return result;
}

static bool ST7735S_WriteData(const uint8_t *data, uint16_t length)
{
    bool result;

    HAL_GPIO_WritePin(TFT_DC_GPIO_Port, TFT_DC_Pin, GPIO_PIN_SET);
    ST7735S_Select();
    result = ST7735S_Transmit(data, length);
    ST7735S_Unselect();

    return result;
}

static bool ST7735S_WriteCommandData(uint8_t command,
                                     const uint8_t *data,
                                     uint16_t length)
{
    if (!ST7735S_WriteCommand(command))
    {
        return false;
    }

    if (length == 0U)
    {
        return true;
    }

    return ST7735S_WriteData(data, length);
}
```

- [x] **Step 2: Add backlight and hardware reset helpers**

```c
void BSP_ST7735S_SetBacklight(bool enabled)
{
    HAL_GPIO_WritePin(TFT_BLK_GPIO_Port,
                      TFT_BLK_Pin,
                      enabled ? GPIO_PIN_SET : GPIO_PIN_RESET);
}

static void ST7735S_HardwareReset(void)
{
    HAL_GPIO_WritePin(TFT_RST_GPIO_Port, TFT_RST_Pin, GPIO_PIN_SET);
    HAL_Delay(10U);
    HAL_GPIO_WritePin(TFT_RST_GPIO_Port, TFT_RST_Pin, GPIO_PIN_RESET);
    HAL_Delay(20U);
    HAL_GPIO_WritePin(TFT_RST_GPIO_Port, TFT_RST_Pin, GPIO_PIN_SET);
    HAL_Delay(120U);
}
```

- [x] **Step 3: Add the complete initialization sequence**

Append:

```c
bool BSP_ST7735S_Init(void)
{
    static const uint8_t frame_rate[] = { 0x01U, 0x2CU, 0x2DU };
    static const uint8_t frame_rate_idle[] =
    {
        0x01U, 0x2CU, 0x2DU, 0x01U, 0x2CU, 0x2DU
    };
    static const uint8_t inversion_control[] = { 0x07U };
    static const uint8_t power_control_1[] = { 0xA2U, 0x02U, 0x84U };
    static const uint8_t power_control_2[] = { 0xC5U };
    static const uint8_t power_control_3[] = { 0x0AU, 0x00U };
    static const uint8_t power_control_4[] = { 0x8AU, 0x2AU };
    static const uint8_t power_control_5[] = { 0x8AU, 0xEEU };
    static const uint8_t vcom_control[] = { 0x0EU };
    static const uint8_t pixel_format[] = { 0x05U };
    static const uint8_t madctl[] = { ST7735S_MADCTL_PORTRAIT };
    static const uint8_t positive_gamma[] =
    {
        0x02U, 0x1CU, 0x07U, 0x12U,
        0x37U, 0x32U, 0x29U, 0x2DU,
        0x29U, 0x25U, 0x2BU, 0x39U,
        0x00U, 0x01U, 0x03U, 0x10U
    };
    static const uint8_t negative_gamma[] =
    {
        0x03U, 0x1DU, 0x07U, 0x06U,
        0x2EU, 0x2CU, 0x29U, 0x2DU,
        0x2EU, 0x2EU, 0x37U, 0x3FU,
        0x00U, 0x00U, 0x02U, 0x10U
    };

    BSP_ST7735S_SetBacklight(false);
    ST7735S_Unselect();
    ST7735S_HardwareReset();

    if (!ST7735S_WriteCommand(ST7735S_CMD_SWRESET))
    {
        return false;
    }
    HAL_Delay(150U);

    if (!ST7735S_WriteCommand(ST7735S_CMD_SLPOUT))
    {
        return false;
    }
    HAL_Delay(120U);

    if (!ST7735S_WriteCommandData(ST7735S_CMD_FRMCTR1,
                                  frame_rate,
                                  sizeof(frame_rate)) ||
        !ST7735S_WriteCommandData(ST7735S_CMD_FRMCTR2,
                                  frame_rate,
                                  sizeof(frame_rate)) ||
        !ST7735S_WriteCommandData(ST7735S_CMD_FRMCTR3,
                                  frame_rate_idle,
                                  sizeof(frame_rate_idle)) ||
        !ST7735S_WriteCommandData(ST7735S_CMD_INVCTR,
                                  inversion_control,
                                  sizeof(inversion_control)) ||
        !ST7735S_WriteCommandData(ST7735S_CMD_PWCTR1,
                                  power_control_1,
                                  sizeof(power_control_1)) ||
        !ST7735S_WriteCommandData(ST7735S_CMD_PWCTR2,
                                  power_control_2,
                                  sizeof(power_control_2)) ||
        !ST7735S_WriteCommandData(ST7735S_CMD_PWCTR3,
                                  power_control_3,
                                  sizeof(power_control_3)) ||
        !ST7735S_WriteCommandData(ST7735S_CMD_PWCTR4,
                                  power_control_4,
                                  sizeof(power_control_4)) ||
        !ST7735S_WriteCommandData(ST7735S_CMD_PWCTR5,
                                  power_control_5,
                                  sizeof(power_control_5)) ||
        !ST7735S_WriteCommandData(ST7735S_CMD_VMCTR1,
                                  vcom_control,
                                  sizeof(vcom_control)) ||
        !ST7735S_WriteCommand(ST7735S_CMD_INVOFF) ||
        !ST7735S_WriteCommandData(ST7735S_CMD_MADCTL,
                                  madctl,
                                  sizeof(madctl)) ||
        !ST7735S_WriteCommandData(ST7735S_CMD_COLMOD,
                                  pixel_format,
                                  sizeof(pixel_format)) ||
        !ST7735S_WriteCommandData(ST7735S_CMD_GMCTRP1,
                                  positive_gamma,
                                  sizeof(positive_gamma)) ||
        !ST7735S_WriteCommandData(ST7735S_CMD_GMCTRN1,
                                  negative_gamma,
                                  sizeof(negative_gamma)))
    {
        return false;
    }

    if (!ST7735S_WriteCommand(ST7735S_CMD_NORON))
    {
        return false;
    }
    HAL_Delay(10U);

    if (!ST7735S_WriteCommand(ST7735S_CMD_DISPON))
    {
        return false;
    }
    HAL_Delay(100U);

    if (!BSP_ST7735S_FillScreen(ST7735S_COLOR_BLACK))
    {
        return false;
    }

    BSP_ST7735S_SetBacklight(true);
    return true;
}
```

The graphics functions referenced at the end are implemented in Task 6 before this module is built.

### Task 6: Implement the LVGL-Ready Pixel Path and Graphics Primitives

**Files:**

- Modify: `firmware/SmartHood/BSP/Src/bsp_st7735s.c`

- [x] **Step 1: Add address-window programming**

```c
bool BSP_ST7735S_SetAddressWindow(uint16_t x,
                                 uint16_t y,
                                 uint16_t width,
                                 uint16_t height)
{
    uint16_t x_end;
    uint16_t y_end;
    uint8_t coordinates[4];

    if ((width == 0U) || (height == 0U) ||
        (x >= ST7735S_WIDTH) || (y >= ST7735S_HEIGHT) ||
        (width > (ST7735S_WIDTH - x)) ||
        (height > (ST7735S_HEIGHT - y)))
    {
        return false;
    }

    x = (uint16_t)(x + ST7735S_X_OFFSET);
    y = (uint16_t)(y + ST7735S_Y_OFFSET);
    x_end = (uint16_t)(x + width - 1U);
    y_end = (uint16_t)(y + height - 1U);

    coordinates[0] = (uint8_t)(x >> 8);
    coordinates[1] = (uint8_t)x;
    coordinates[2] = (uint8_t)(x_end >> 8);
    coordinates[3] = (uint8_t)x_end;
    if (!ST7735S_WriteCommandData(ST7735S_CMD_CASET,
                                  coordinates,
                                  sizeof(coordinates)))
    {
        return false;
    }

    coordinates[0] = (uint8_t)(y >> 8);
    coordinates[1] = (uint8_t)y;
    coordinates[2] = (uint8_t)(y_end >> 8);
    coordinates[3] = (uint8_t)y_end;
    if (!ST7735S_WriteCommandData(ST7735S_CMD_RASET,
                                  coordinates,
                                  sizeof(coordinates)))
    {
        return false;
    }

    return ST7735S_WriteCommand(ST7735S_CMD_RAMWR);
}
```

- [x] **Step 2: Add continuous RGB565 pixel writing**

```c
bool BSP_ST7735S_WritePixels(const uint16_t *pixels, uint32_t count)
{
    uint8_t buffer[ST7735S_PIXEL_CHUNK * 2U];
    uint32_t processed = 0U;
    uint32_t chunk;
    uint32_t index;

    if ((pixels == NULL) || (count == 0U))
    {
        return false;
    }

    while (processed < count)
    {
        chunk = count - processed;
        if (chunk > ST7735S_PIXEL_CHUNK)
        {
            chunk = ST7735S_PIXEL_CHUNK;
        }

        for (index = 0U; index < chunk; index++)
        {
            buffer[index * 2U] =
                (uint8_t)(pixels[processed + index] >> 8);
            buffer[(index * 2U) + 1U] =
                (uint8_t)pixels[processed + index];
        }

        if (!ST7735S_WriteData(buffer, (uint16_t)(chunk * 2U)))
        {
            return false;
        }

        processed += chunk;
    }

    return true;
}

static bool ST7735S_WriteRepeatedColor(uint16_t color, uint32_t count)
{
    uint16_t pixels[ST7735S_PIXEL_CHUNK];
    uint32_t chunk;
    uint32_t index;

    for (index = 0U; index < ST7735S_PIXEL_CHUNK; index++)
    {
        pixels[index] = color;
    }

    while (count > 0U)
    {
        chunk = count;
        if (chunk > ST7735S_PIXEL_CHUNK)
        {
            chunk = ST7735S_PIXEL_CHUNK;
        }

        if (!BSP_ST7735S_WritePixels(pixels, chunk))
        {
            return false;
        }

        count -= chunk;
    }

    return true;
}
```

- [x] **Step 3: Add rectangle, full-screen and pixel functions**

```c
bool BSP_ST7735S_FillRect(uint16_t x,
                         uint16_t y,
                         uint16_t width,
                         uint16_t height,
                         uint16_t color)
{
    if ((width == 0U) || (height == 0U) ||
        (x >= ST7735S_WIDTH) || (y >= ST7735S_HEIGHT))
    {
        return false;
    }

    if (width > (ST7735S_WIDTH - x))
    {
        width = (uint16_t)(ST7735S_WIDTH - x);
    }
    if (height > (ST7735S_HEIGHT - y))
    {
        height = (uint16_t)(ST7735S_HEIGHT - y);
    }

    if (!BSP_ST7735S_SetAddressWindow(x, y, width, height))
    {
        return false;
    }

    return ST7735S_WriteRepeatedColor(
        color,
        (uint32_t)width * (uint32_t)height);
}

bool BSP_ST7735S_FillScreen(uint16_t color)
{
    return BSP_ST7735S_FillRect(0U,
                               0U,
                               ST7735S_WIDTH,
                               ST7735S_HEIGHT,
                               color);
}

bool BSP_ST7735S_DrawPixel(uint16_t x, uint16_t y, uint16_t color)
{
    return BSP_ST7735S_FillRect(x, y, 1U, 1U, color);
}
```

- [x] **Step 4: Add minimal character and string rendering**

```c
bool BSP_ST7735S_DrawChar(uint16_t x,
                         uint16_t y,
                         char character,
                         uint16_t foreground,
                         uint16_t background)
{
    uint8_t glyph[FONT_5X7_WIDTH];
    uint8_t column;
    uint8_t row;
    uint8_t bits;

    if ((x + FONT_5X7_WIDTH >= ST7735S_WIDTH) ||
        (y + FONT_5X7_HEIGHT > ST7735S_HEIGHT) ||
        !Fonts_GetGlyph5x7(character, glyph))
    {
        return false;
    }

    for (column = 0U; column < FONT_5X7_WIDTH; column++)
    {
        bits = glyph[column];
        for (row = 0U; row < FONT_5X7_HEIGHT; row++)
        {
            if (!BSP_ST7735S_DrawPixel(
                    (uint16_t)(x + column),
                    (uint16_t)(y + row),
                    ((bits & 0x01U) != 0U) ? foreground : background))
            {
                return false;
            }
            bits >>= 1;
        }
    }

    return BSP_ST7735S_FillRect((uint16_t)(x + FONT_5X7_WIDTH),
                                y,
                                1U,
                                FONT_5X7_HEIGHT,
                                background);
}

bool BSP_ST7735S_DrawString(uint16_t x,
                           uint16_t y,
                           const char *text,
                           uint16_t foreground,
                           uint16_t background)
{
    uint16_t cursor_x = x;
    uint16_t cursor_y = y;

    if (text == NULL)
    {
        return false;
    }

    while (*text != '\0')
    {
        if (*text == '\n')
        {
            cursor_x = x;
            cursor_y = (uint16_t)(cursor_y + FONT_5X7_HEIGHT + 1U);
            text++;
            continue;
        }

        if ((cursor_x + FONT_5X7_WIDTH + 1U) > ST7735S_WIDTH)
        {
            cursor_x = x;
            cursor_y = (uint16_t)(cursor_y + FONT_5X7_HEIGHT + 1U);
        }

        if ((cursor_y + FONT_5X7_HEIGHT) > ST7735S_HEIGHT)
        {
            return false;
        }

        if (!BSP_ST7735S_DrawChar(cursor_x,
                                  cursor_y,
                                  *text,
                                  foreground,
                                  background))
        {
            return false;
        }

        cursor_x = (uint16_t)(cursor_x + FONT_5X7_WIDTH + 1U);
        text++;
    }

    return true;
}
```

- [x] **Step 5: Add `bsp_st7735s.c` to the Keil BSP group and build**

Expected:

```text
compiling bsp_st7735s.c...
0 Error(s), 0 Warning(s)
```

At this point the functions are not yet referenced, so linker size changes may be limited.

- [x] **Step 6: Commit the BSP driver**

```powershell
git add firmware/SmartHood/BSP firmware/SmartHood/MDK-ARM/SmartHood.uvprojx
git commit -m "feat: add blocking ST7735S BSP driver"
git push
```

### Task 7: Integrate the Display Hardware Test into the Default Task

**Files:**

- Modify: `firmware/SmartHood/App/Src/app_tasks.c`

- [x] **Step 1: Include the display header**

Add after the existing application includes:

```c
#include "bsp_st7735s.h"
```

- [x] **Step 2: Add a local test-screen helper above `App_DefaultTask`**

```c
static bool App_RunDisplayTest(void)
{
    if (!BSP_ST7735S_Init())
    {
        return false;
    }

    if (!BSP_ST7735S_FillScreen(ST7735S_COLOR_RED))
    {
        return false;
    }
    osDelay(500U);

    if (!BSP_ST7735S_FillScreen(ST7735S_COLOR_GREEN))
    {
        return false;
    }
    osDelay(500U);

    if (!BSP_ST7735S_FillScreen(ST7735S_COLOR_BLUE))
    {
        return false;
    }
    osDelay(500U);

    if (!BSP_ST7735S_FillScreen(ST7735S_COLOR_WHITE))
    {
        return false;
    }
    osDelay(500U);

    if (!BSP_ST7735S_FillScreen(ST7735S_COLOR_BLACK))
    {
        return false;
    }

    if (!BSP_ST7735S_FillRect(0U, 0U, 128U, 1U, ST7735S_COLOR_WHITE) ||
        !BSP_ST7735S_FillRect(0U, 159U, 128U, 1U, ST7735S_COLOR_WHITE) ||
        !BSP_ST7735S_FillRect(0U, 0U, 1U, 160U, ST7735S_COLOR_WHITE) ||
        !BSP_ST7735S_FillRect(127U, 0U, 1U, 160U, ST7735S_COLOR_WHITE) ||
        !BSP_ST7735S_FillRect(2U, 2U, 8U, 8U, ST7735S_COLOR_RED) ||
        !BSP_ST7735S_FillRect(118U, 2U, 8U, 8U, ST7735S_COLOR_GREEN) ||
        !BSP_ST7735S_FillRect(2U, 150U, 8U, 8U, ST7735S_COLOR_BLUE) ||
        !BSP_ST7735S_FillRect(118U, 150U, 8U, 8U, ST7735S_COLOR_YELLOW) ||
        !BSP_ST7735S_DrawString(12U,
                                50U,
                                "SmartHood",
                                ST7735S_COLOR_WHITE,
                                ST7735S_COLOR_BLACK) ||
        !BSP_ST7735S_DrawString(12U,
                                70U,
                                "ST7735S OK",
                                ST7735S_COLOR_CYAN,
                                ST7735S_COLOR_BLACK) ||
        !BSP_ST7735S_DrawString(12U,
                                90U,
                                "128x160",
                                ST7735S_COLOR_YELLOW,
                                ST7735S_COLOR_BLACK))
    {
        return false;
    }

    return true;
}
```

- [x] **Step 3: Call the test once when the task starts**

Inside `App_DefaultTask`, after:

```c
DebugLog_Printf("\r\nSmartHood M1 start\r\n");
```

add:

```c
if (App_RunDisplayTest())
{
    DebugLog_Printf("ST7735S init and test OK\r\n");
}
else
{
    BSP_ST7735S_SetBacklight(false);
    DebugLog_Printf("ST7735S init or draw failed\r\n");
}
```

Keep the existing heartbeat loop unchanged.

- [x] **Step 4: Build the integrated firmware**

Press `F7`.

Expected:

```text
0 Error(s), 0 Warning(s)
```

The code and read-only data sizes should increase because the driver and font are now referenced.

Do not flash until the unpowered wiring in Task 8 has been checked.

### Task 8: Wire and Validate the TFT

**Files:**

- Update: `docs/hardware-connections.md`
- Update: `docs/test-records.md`
- Update: `docs/project-guide.md`

- [x] **Step 1: Power everything off**

Disconnect the board USB-C, ST-Link USB and USB-to-UART USB before moving any TFT wire.

- [x] **Step 2: Connect the eight TFT pins**

```text
TFT BLK -> PD4
TFT CS  -> PD7
TFT DC  -> PD6
TFT RST -> PD5
TFT SDA -> PB15 / SPI2_MOSI
TFT SCL -> PB13 / SPI2_SCK
TFT VDD -> board 3.3V
TFT GND -> board GND
```

Do not connect TFT VDD to 5V.

- [x] **Step 3: Reconnect debug and serial wiring without power pins**

```text
ST-Link SWDIO -> board DIO
ST-Link SWCLK -> board CLK
ST-Link GND   -> board GND
USB-UART RX   -> PA9
USB-UART GND  -> board GND
```

ST-Link 3.3V/5V and USB-UART 3.3V/5V remain disconnected.

- [x] **Step 4: Power the board and confirm no abnormal heating**

Power the board from USB-C. Stop immediately if the TFT, STM32 board or cable becomes hot, smells abnormal or causes the board power LED to collapse.

- [x] **Step 5: Flash the firmware**

Use `F8`. Expected:

```text
Erase Done.
Programming Done.
Verify OK.
```

- [x] **Step 6: Record the backlight result**

Confirm whether PD4 High turns the backlight on. If the polarity is reversed, change only `BSP_ST7735S_SetBacklight()` and rebuild.

- [x] **Step 7: Record the color sequence**

Expected sequence after reset:

```text
red -> green -> blue -> white -> black -> final test screen
```

If red and blue are swapped, change `ST7735S_MADCTL_PORTRAIT` from `0xC8U` to the tested RGB/BGR alternative and repeat.

- [x] **Step 8: Verify direction, corners and offsets**

Expected final portrait screen:

```text
top-left: red square
top-right: green square
bottom-left: blue square
bottom-right: yellow square
white border visible on all four edges
```

If the image is mirrored, inverted or shifted, record the exact observed corner positions before changing MADCTL or X/Y offsets.

- [x] **Step 9: Verify the text and M1 heartbeat**

Expected display text:

```text
SmartHood
ST7735S OK
128x160
```

Expected serial output includes:

```text
ST7735S init and test OK
heartbeat=... key=... tick=...
```

Press PA0 once to confirm `key=1`, and observe that PA1 still toggles.

- [x] **Step 10: Update the living documents**

Record:

- Final backlight active level.
- Final MADCTL value.
- Final X/Y offsets.
- Color test result.
- Corner/border result.
- Text result.
- Build size and warning count.
- Any display instability or skipped duration test.

- [x] **Step 11: Commit the M2 result**

```powershell
git add firmware/SmartHood docs
git commit -m "feat: validate ST7735S display"
git push
```

- [x] **Step 12: Stop at the M2 checkpoint**

Do not enable DMA or add LVGL. M3 starts only after the M2 hardware result and final calibration values have been reviewed.
