icecoke0913-code/STM32F4-ventilator/参数/st7735正面.JPG

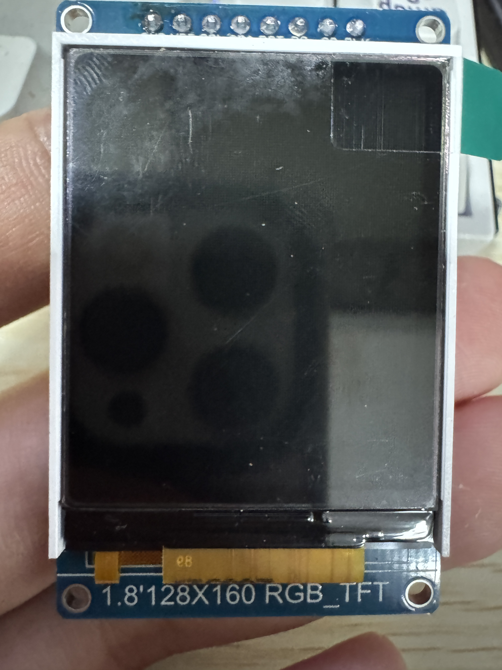
参数/st7735正面.JPG
