icecoke0913-code/STM32F4-ventilator/参数/电机参数.png

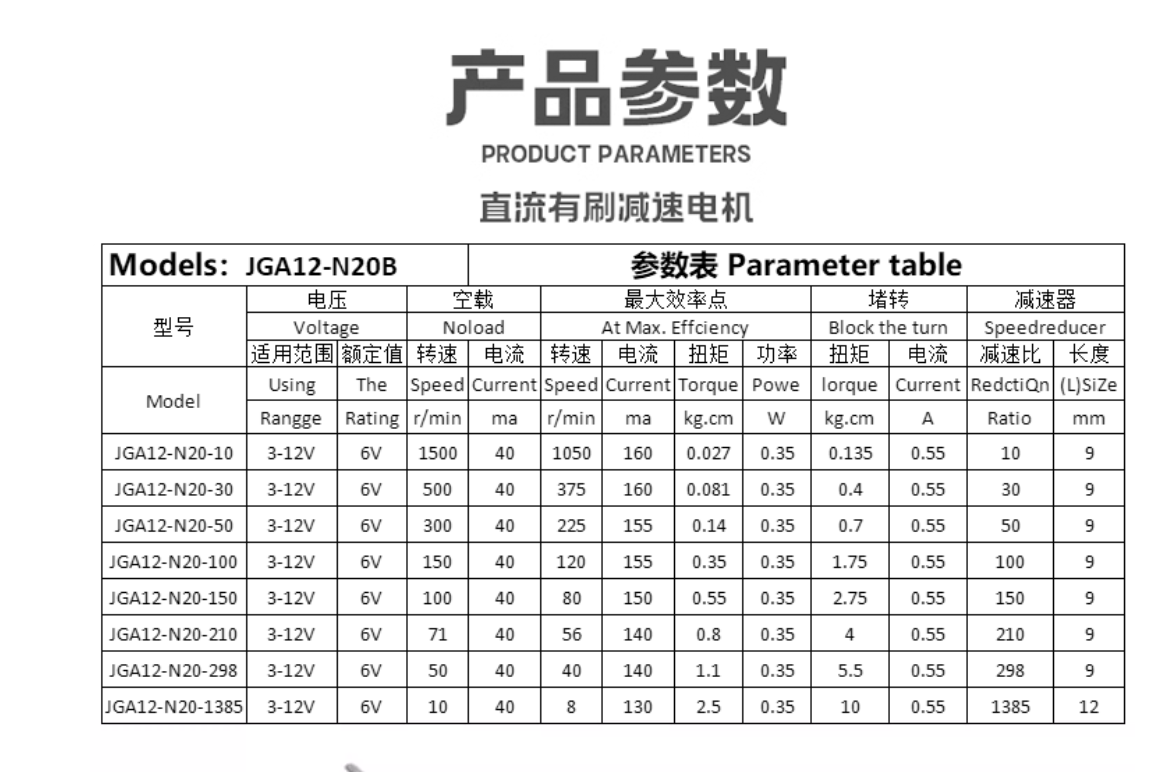
参数/电机参数.png
