icecoke0913-code/STM32F4-ventilator/参数/电源模块.png

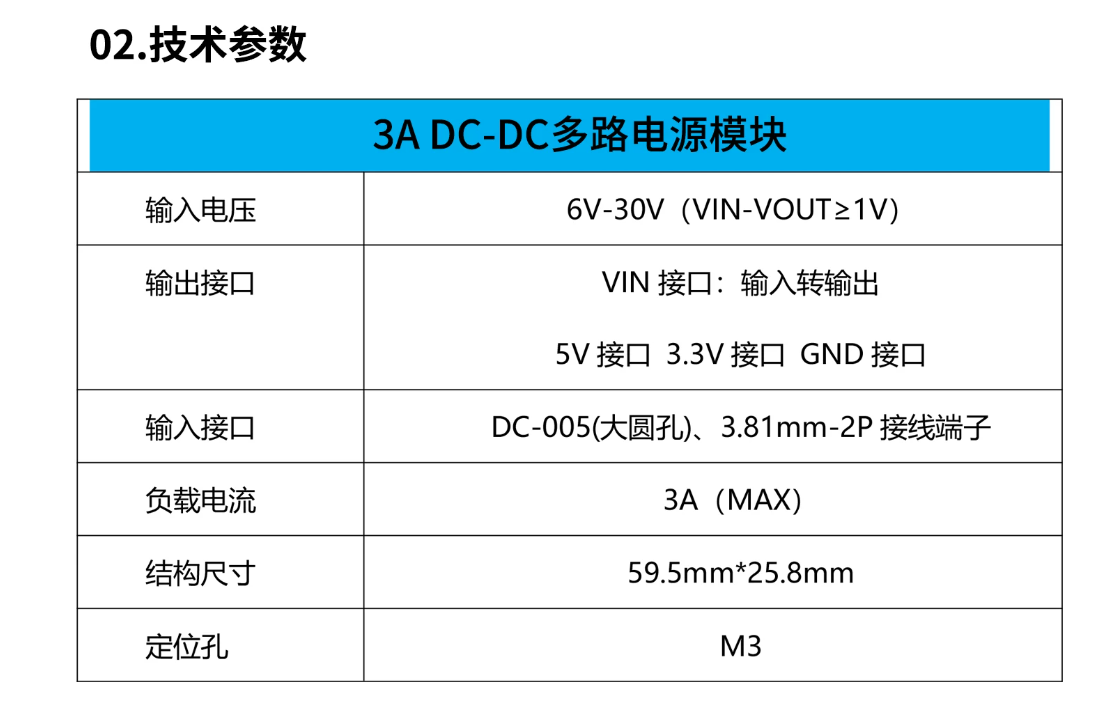
参数/电源模块.png
