icecoke0913-code/STM32F4-ventilator/firmware/SmartHood/SmartHood.ioc

Mcu.UserName=STM32F407VETx
PA0-WKUP.GPIO_Label=USER_KEY
PA0-WKUP.Signal=GPIO_Input
PA1.GPIO_Label=BOARD_LED
PA1.Signal=GPIO_Output
PA10.Signal=USART1_RX
PA13.Signal=SYS_JTMS-SWDIO
PA14.Signal=SYS_JTCK-SWCLK
PA9.Signal=USART1_TX
PB13.Signal=SPI2_SCK
PB15.Signal=SPI2_MOSI
PB6.Signal=S_TIM4_CH1
PB7.GPIO_Label=MOTOR_AIN1
PB7.Signal=GPIO_Output
PB8.GPIO_Label=MOTOR_AIN2
PB8.Signal=GPIO_Output
PB9.GPIO_Label=MOTOR_STBY
PB9.Signal=GPIO_Output
PC6.Signal=S_TIM3_CH1
PC7.Signal=S_TIM3_CH2
PD0.GPIO_Label=DHT11_DATA
PD0.Signal=GPIO_Input
PD4.GPIO_Label=TFT_BLK
PD4.Signal=GPIO_Output
PD5.GPIO_Label=TFT_RST
PD5.Signal=GPIO_Output
PD6.GPIO_Label=TFT_DC
PD6.Signal=GPIO_Output
PD7.GPIO_Label=TFT_CS
PD7.Signal=GPIO_Output
PH0-OSC_IN.Signal=RCC_OSC_IN
PH1-OSC_OUT.Signal=RCC_OSC_OUT
