icecoke0913-code/STM32F4-ventilator/(commit log)

2026-07-25 feat: add blocking ST7735S BSP driver
2026-07-26 feat: configure TIM5 and DHT11 sensor task
2026-07-26 refactor: make debug logging thread safe
2026-08-02 feat: add TIM5-based DHT11 BSP driver
2026-08-02 feat: integrate periodic DHT11 sensor task
2026-08-04 docs: design M4 open-loop motor control
2026-08-04 docs: add M4 motor implementation plan
2026-08-05 feat: configure TIM4 motor PWM outputs
2026-08-06 feat: add TB6612 motor BSP
2026-08-06 feat: add PA0 motor duty control
2026-08-06 test: validate motor control without hardware
2026-08-06 feat: validate TB6612 open-loop motor control
2026-08-08 docs: add M5 encoder measurement design
2026-08-08 docs: add M5 encoder implementation plan
2026-08-12 feat: configure TIM3 encoder interface
2026-08-12 feat: add TIM3 encoder BSP
2026-08-15 feat: add motor encoder measurement task
2026-08-15 test: record M5 encoder speed results
2026-08-15 docs: finalize M5 encoder validation
2026-08-15 feat: add fixed-point PI controller
    [app_tasks.c, control_pi.c]
2026-08-15 refactor: route motor commands to MotorTask
2026-08-16 refactor: route M7 key events to MotorTask
2026-08-17 feat: integrate M7 mode state with motor control
2026-08-18 docs: record MQ-2 module voltage limits
